g7ltt/USB-Soundcard-Interface-for-Digital-Modes/README.md

# USB Soundcard Interface for Digital Modes

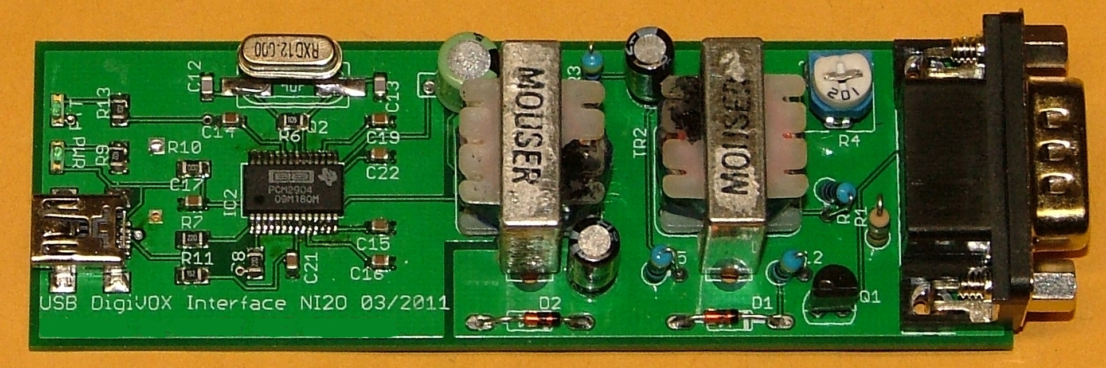
[picture p1: usb-radio-sound-card-interface-actual.jpg]
finished device


All-in-one interface for ham radio digital modes. Includes a USB sound card for simpler wiring. Uses VOX for PTT.
