g7ltt/USB-Soundcard-Interface-for-Digital-Modes/USB DigiVOX Interface V5.pdf

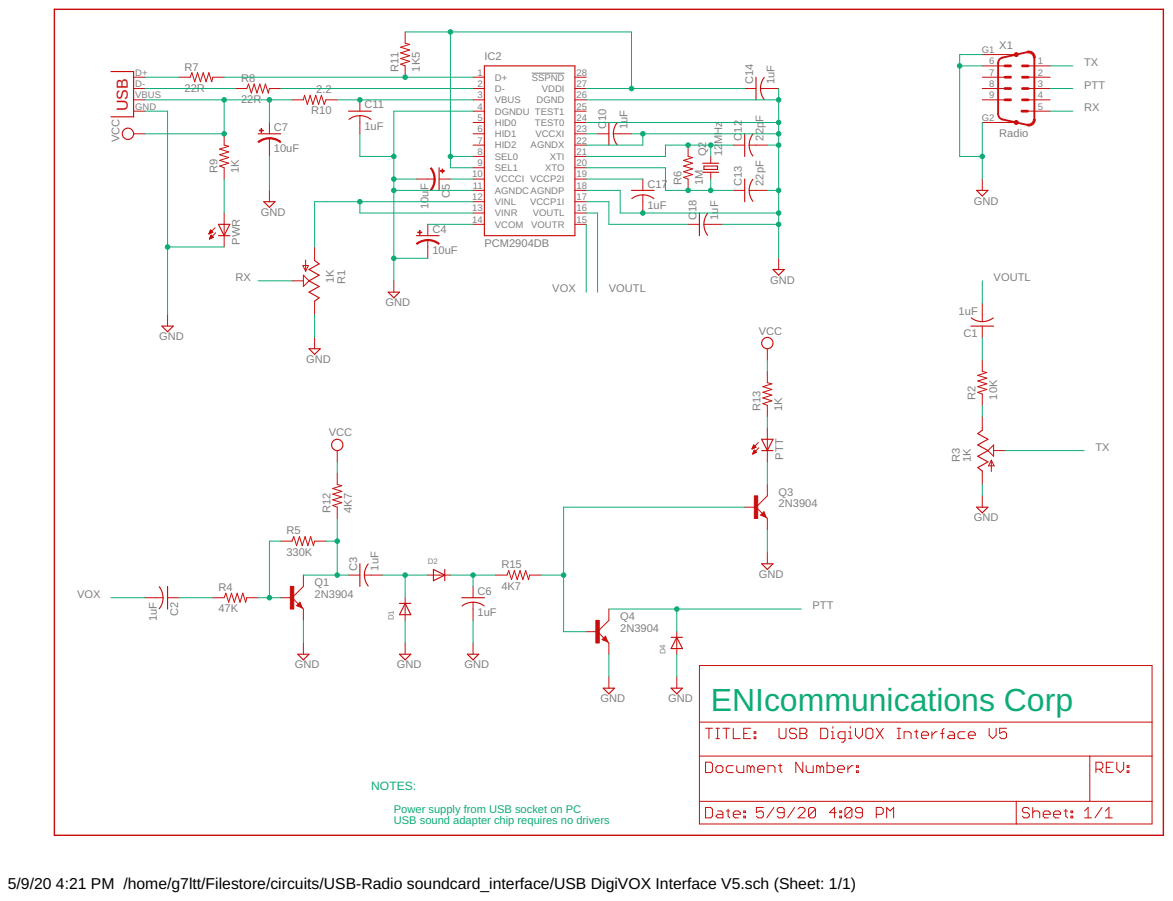
[picture p3: page 1]

NOTES: Power supply from USB socket on PC

5/9/20 4:21 PM /home/g7ltt/Filestore/circuits/USB-Radio soundcard_interface/USB DigiVOX Interface V5.sch (Sheet: 1/1)
