g7ltt/USB-Soundcard-Interface-for-Digital-Modes/USB DigiVOX Interface V5.brd

## EAGLE design USB DigiVOX Interface V5.brd (2021-11-11)

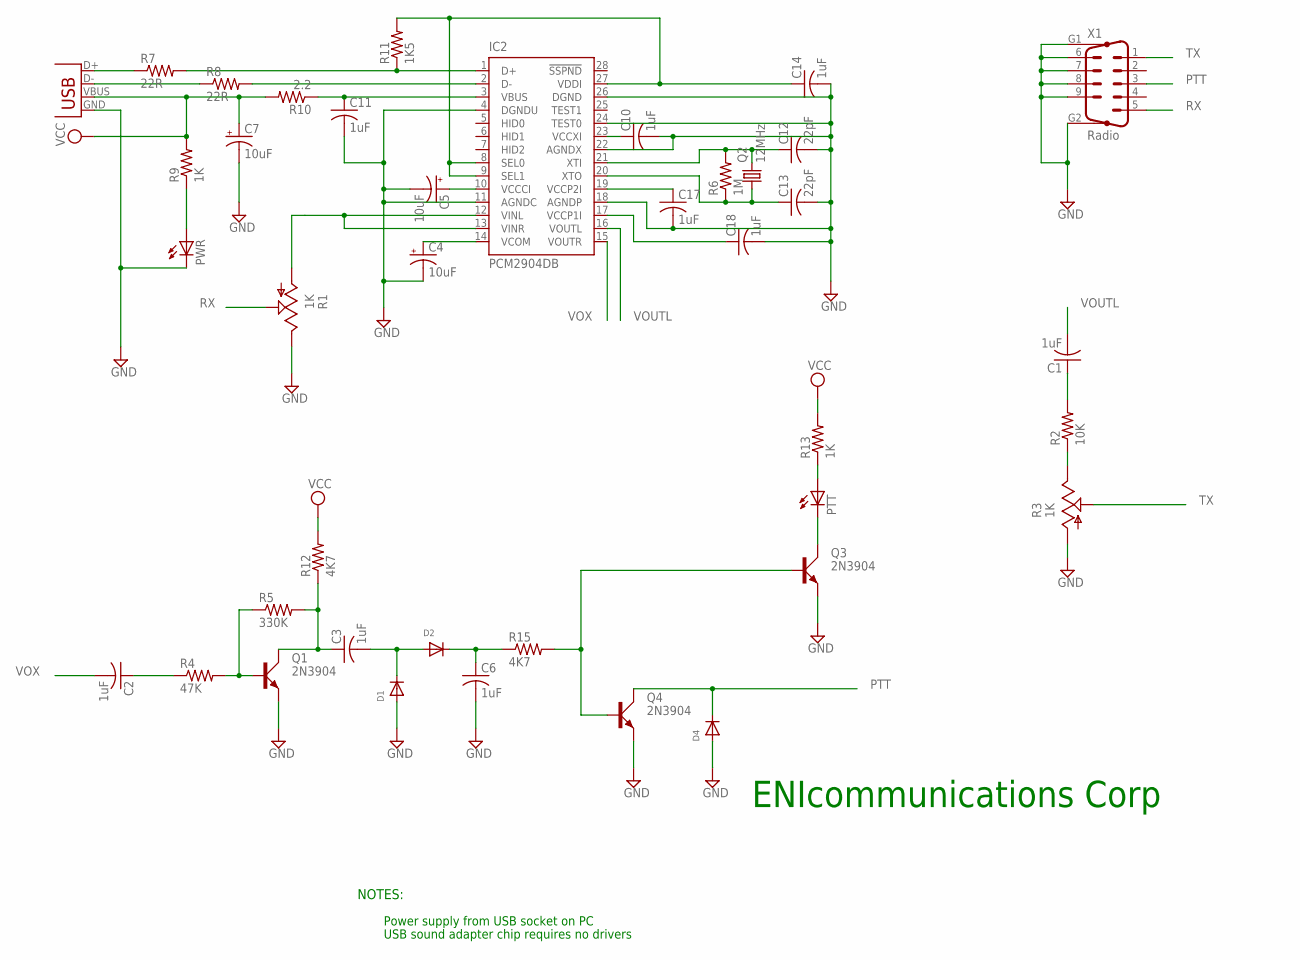
[picture p4: schematic USB DigiVOX Interface V5.sch]

Parts:
C1, C2, C3, C6, C10, C11, C14, C17, C18: 1uF; C025-025X050
C4, C5, C7: 10uF; CPOL-RADIAL-10UF-25V
C12, C13: 22pF; C025-025X050
D1, D2, D4: DIODEDO-1N4148; DO-1N4148
IC2: PCM2904DB; SSOP28DB
PTT: LED3MM
PWR: LED3MM
Q1, Q3, Q4: 2N3904; TO92D
Q2: 12MHz; HC49/S
R1, R3: 1K; CA6V
R2: 10K; 0204/7
R4: 47K; 0207/2V
R5: 330K; 0207/2V
R6: 1M; 0207/2V
R7, R8: 22R; 0207/2V
R9: 1K; 0207/2V
R10: 2.2; 0207/2V
R11: 1K5; 0207/2V
R12, R15: 4K7; 0207/2V
R13: 1K; 0204/7
X1: Radio; M09HP
X2: USBSMD; USB-MINIB

Connections:
GND: C4.2 (-), C5.2 (-), C6.2, C7.2 (-), C10.2, C11.2, C12.2, C13.2, C14.2, C17.2, C18.2, D1.A, D4.A, IC2.4 (DGNDU), IC2.11 (AGNDC), IC2.18 (AGNDP), IC2.22 (AGNDX), IC2.24 (TEST0), IC2.26 (DGND), PWR.K (C), Q1.E, Q3.E, Q4.E, R1.E, R3.A, X1.6, X1.7, X1.8, X1.9, X1.G1, X1.G2, X2.GND
unnamed: C1.1, R2.2
unnamed: R2.1, R3.E
unnamed: C5.1 (+), IC2.10 (VCCCI)
unnamed: C12.1, IC2.21 (XTI), Q2.2, R6.2
unnamed: PWR.A, R9.1
unnamed: C13.1, IC2.20 (XTO), Q2.1, R6.1
unnamed: C10.1, IC2.23 (VCCXI)
unnamed: C2.1, R4.1
unnamed: C4.1 (+), IC2.14 (VCOM)
unnamed: Q1.B, R4.2, R5.1
unnamed: C3.1, Q1.C, R5.2, R12.1
unnamed: C3.2, D1.C, D2.A
unnamed: C14.1, IC2.8 (SEL0), IC2.9 (SEL1), IC2.27 (VDDI), R11.2
unnamed: C6.1, D2.C, R15.1
unnamed: C11.1, IC2.3 (VBUS), R10.1
unnamed: Q3.B, Q4.B, R15.2
unnamed: R7.1, X2.D+
unnamed: C17.1, IC2.19 (VCCP2I)
unnamed: IC2.1 (D+), R7.2, R11.1
unnamed: IC2.2 (D-), R8.2
unnamed: PTT.K (C), Q3.C
unnamed: R8.1, X2.D-
unnamed: PTT.A, R13.1
unnamed: C18.1, IC2.17 (VCCP1I)
PTT: D4.C, Q4.C, X1.3
RX: R1.S, X1.5
TX: R3.S, X1.1
VCC: C7.1 (+), R9.2, R10.2, R12.2, R13.2, X2.VBUS
VINL: IC2.12 (VINL), IC2.13 (VINR), R1.A
VOUTL: C1.2, IC2.16 (VOUTL)
VOX: C2.2, IC2.15 (VOUTR)

Notes on the sheet:
NOTES:
Power supply from USB socket on PC
USB sound adapter chip requires no drivers
ENIcommunications Corp

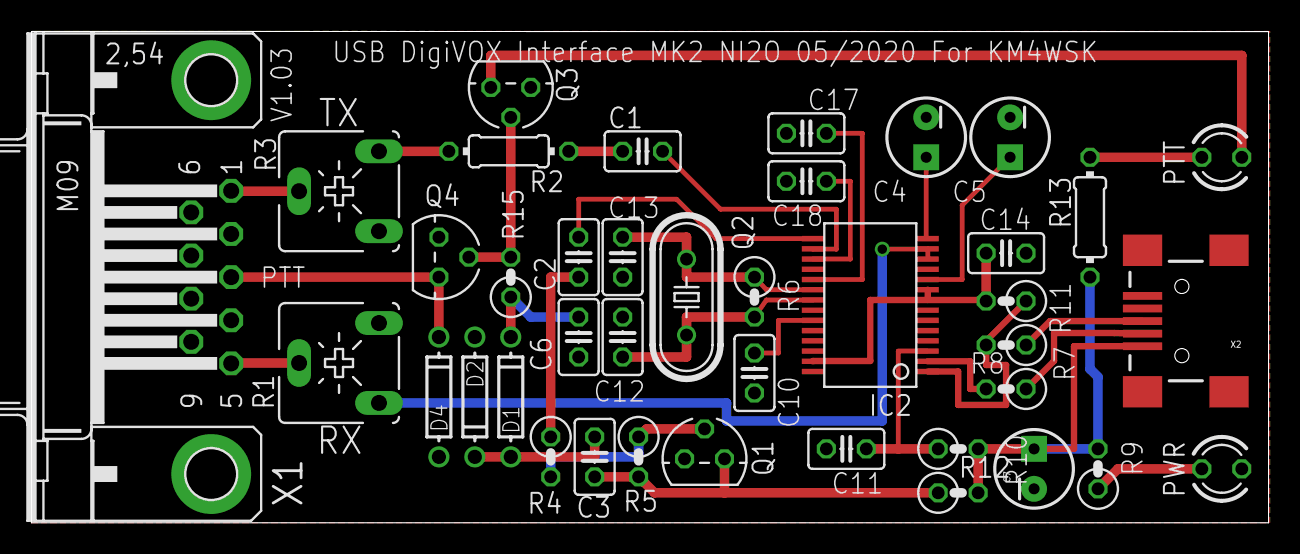
[picture p5: board USB DigiVOX Interface V5.brd from above]

Board: 2 copper layers, 78.7 x 31.2 mm, 40 parts (0 on the bottom side), 32 nets.
