g7ltt/USB-Soundcard-Interface-for-Digital-Modes/USB DigiVOX Interface.brd

## EAGLE design USB DigiVOX Interface.brd (2021-09-01, an earlier design)

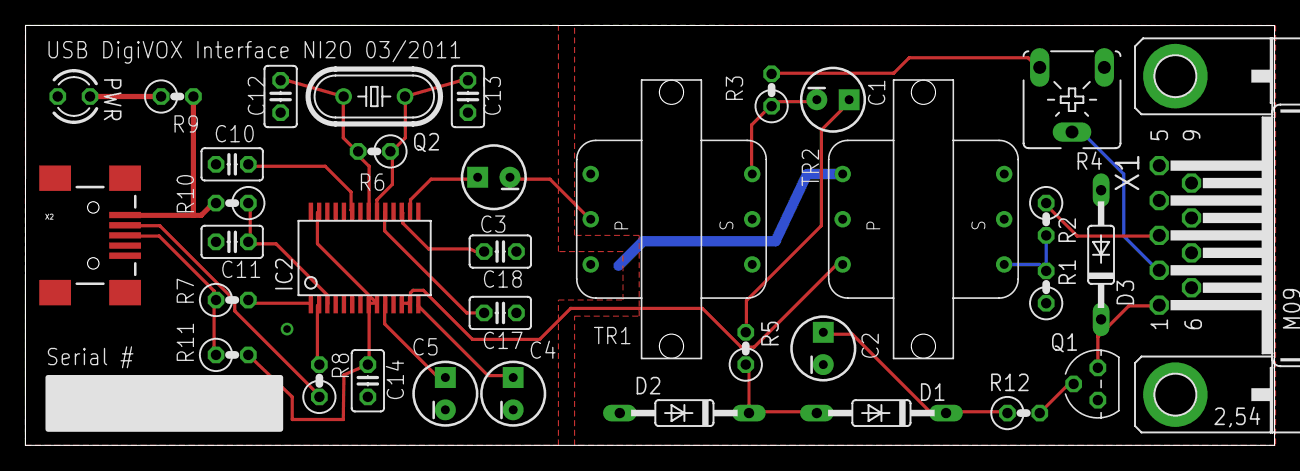
[picture p6: board USB DigiVOX Interface.brd from above]

Board: 2 copper layers, 98.2 x 33.0 mm, 35 parts (0 on the bottom side), 30 nets.

Parts:
C1, C2, C4, C5: 10uF; CPOL-RADIAL-10UF-25V
C3: 4.7uF; CPOL-RADIAL-10UF-25V
C10, C11, C14, C17, C18: 1uF; C025-025X050
C12, C13: 22pF; C025-025X050
D1, D2, D3: 1N4148; DO35-10
IC2: PCM2904DB; SSOP28DB
PWR: LED3MM
Q1: 2N3904; TO92
Q2: 12MHz; HC49/S
R1: 680R; 0207/2V
R2: 10K; 0207/2V
R3, R5: 4k7; 0207/2V
R4: 1K; CA6V
R6: 1M; 0207/2V
R7, R8: 22R; 0207/2V
R9: 1K; 0207/2V
R10: 2.2; 0207/2V
R11: 1K5; 0207/2V
R12: 2k2; 0207/2V
TR1, TR2: 42TM016; 42TM
X1: M09HP
X2: USBSMD; USB-MINIB

Connections:
GND: C4.2, C5.2, C10.2, C11.2, C12.2, C13.2, C14.2, C17.2, C18.2, IC2.4, IC2.11, IC2.18, IC2.22, IC2.24, IC2.26, PWR.K, TR1.3, TR2.1, X2.GND
GNDA: C2.2, D2.A, D3.A, Q1.3, R1.1, R4.A, TR1.4, TR2.6, X1.5, X1.G1, X1.G2
INPUT: IC2.12, IC2.13, TR2.3
unnamed: C3.1, IC2.16
unnamed: C1.2, R3.1, TR1.6
unnamed: C5.1, IC2.10
unnamed: C12.1, IC2.21, Q2.2, R6.2
unnamed: PWR.A, R9.1
unnamed: C13.1, IC2.20, Q2.1, R6.1
unnamed: C10.1, IC2.23
unnamed: R1.2, R2.2, TR2.4
unnamed: C4.1, IC2.14
unnamed: C1.1, R5.2
unnamed: D1.A, D2.C, R5.1
unnamed: C14.1, IC2.8, IC2.9, IC2.27, R11.2
unnamed: C3.2, TR1.2
unnamed: C11.1, IC2.3, R10.1
unnamed: Q1.2, R12.2
unnamed: R3.2, R4.E
unnamed: C17.1, IC2.19
unnamed: R7.1, R11.1, X2.D+
unnamed: IC2.2, R8.2
unnamed: IC2.1, R7.2
unnamed: R8.1, X2.D-
unnamed: C2.1, D1.C, R12.1
unnamed: C18.1, IC2.17
PTT: D3.C, Q1.1, X1.1
RX: R2.1, X1.3
TX: R4.S, X1.2
VCC: R9.2, R10.2, X2.VBUS
