g7ltt/USB-Soundcard-Interface-for-Digital-Modes/Simple USB SC Interface.brd

## EAGLE design Simple USB SC Interface.brd (2021-09-01)

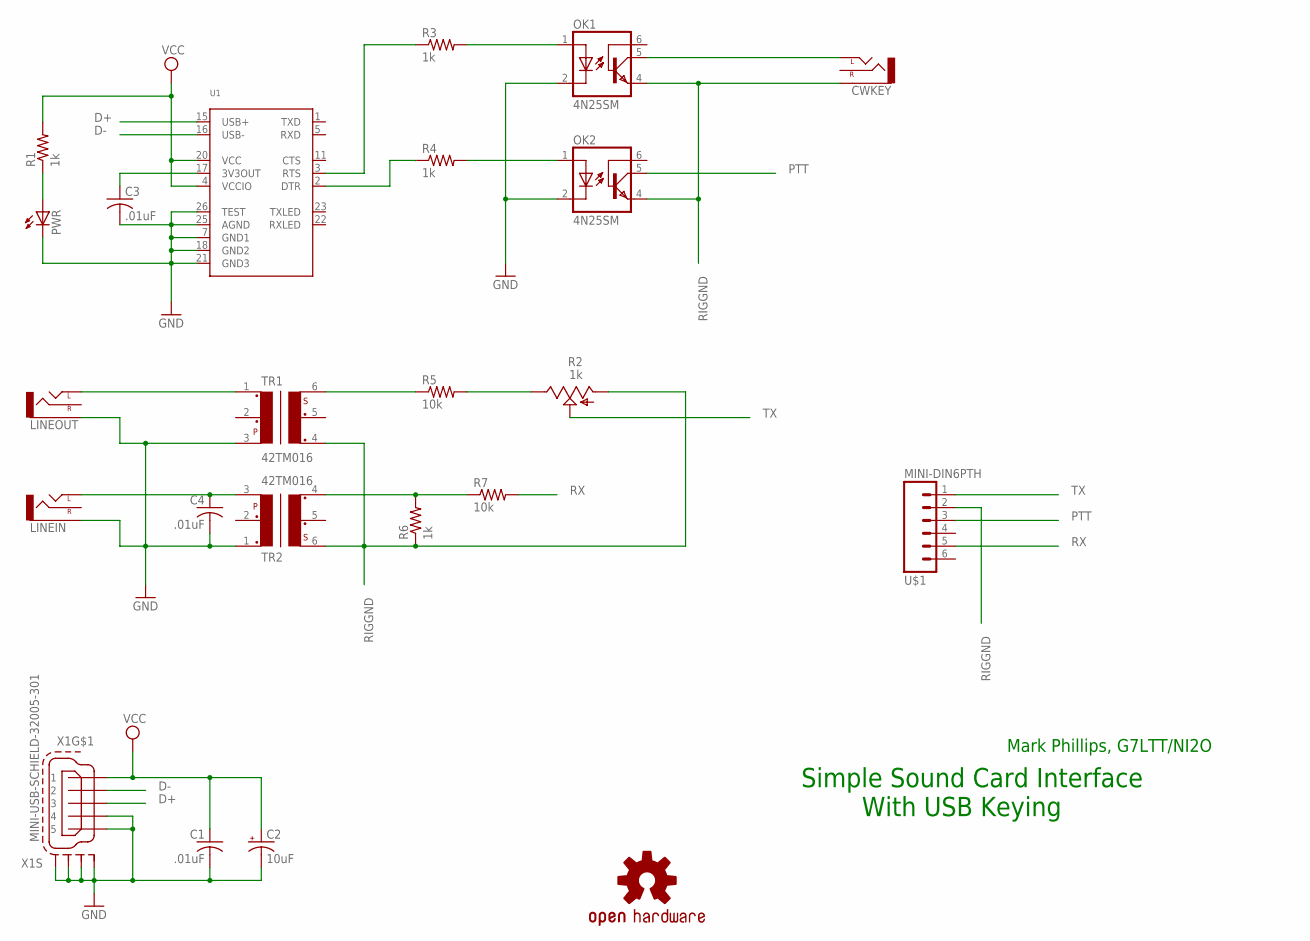
[picture p7: schematic Simple USB SC Interface.sch]

Parts:
C1, C3, C4: .01uF; C0805
C2: 10uF; E2,5-5
CWKEY: AUDIO-JACKSMD2; AUDIO-JACK-3.5MM-SMD
LINEIN: AUDIO-JACKSMD2; AUDIO-JACK-3.5MM-SMD
LINEOUT: AUDIO-JACKSMD2; AUDIO-JACK-3.5MM-SMD
LOGO1: OSHW-LOGOM; OSHW-LOGO-M
OK1, OK2: 4N25SM; DIL6-SMD
PWR: LEDCHIP-LED0805; CHIP-LED0805
R1, R3, R4, R6: 1k; M0805
R2: 1k; CA6V
R5, R7: 10k; M0805
TR1, TR2: 42TM016; 42TM
U1: FT232RLSSOP28; SSOP28DB
U$1: MINI-DIN6PTH; MINI-DIN6
X1: MINI-USB-SCHIELD-32005-301; 32005-301

Connections:
CWKEY: CWKEY.TIP (LEFT), OK1.5 (COL)
D+: U1.15 (USB+), X1.3
D-: U1.16 (USB-), X1.2
GND: C1.2, C2.-, C3.2, C4.2, LINEIN.SLEEVE, LINEOUT.SLEEVE, OK1.2 (C), OK2.2 (C), PWR.C, TR1.3, TR2.1, U1.7 (GND1), U1.18 (GND2), U1.21 (GND3), U1.25 (AGND), U1.26 (TEST), X1.4, X1.5, X1.M1 (S1), X1.M2 (S2), X1.M3 (S3), X1.M4 (S4)
unnamed: PWR.A, R1.1
unnamed: OK1.1 (A), R3.2
unnamed: C3.1, U1.17 (3V3OUT)
unnamed: OK2.1 (A), R4.2
unnamed: R3.1, U1.3 (RTS)
unnamed: R4.1, U1.2 (DTR)
unnamed: C4.1, LINEIN.TIP (LEFT), TR2.3
unnamed: LINEOUT.TIP (LEFT), TR1.1
unnamed: R5.1, TR1.6
unnamed: R2.E, R5.2
unnamed: R6.2, R7.1, TR2.4
PTT: OK2.5 (COL), U$1.3
RIGGND: CWKEY.SLEEVE, OK1.4 (EMI), OK2.4 (EMI), R2.A, R6.1, TR1.4, TR2.6, U$1.2
RX: R7.2, U$1.5
TX: R2.S, U$1.1
VCC: C1.1, C2.+, R1.2, U1.4 (VCCIO), U1.20 (VCC), X1.1

Notes on the sheet:
Simple Sound Card Interface With USB Keying
Mark Phillips, G7LTT/NI2O

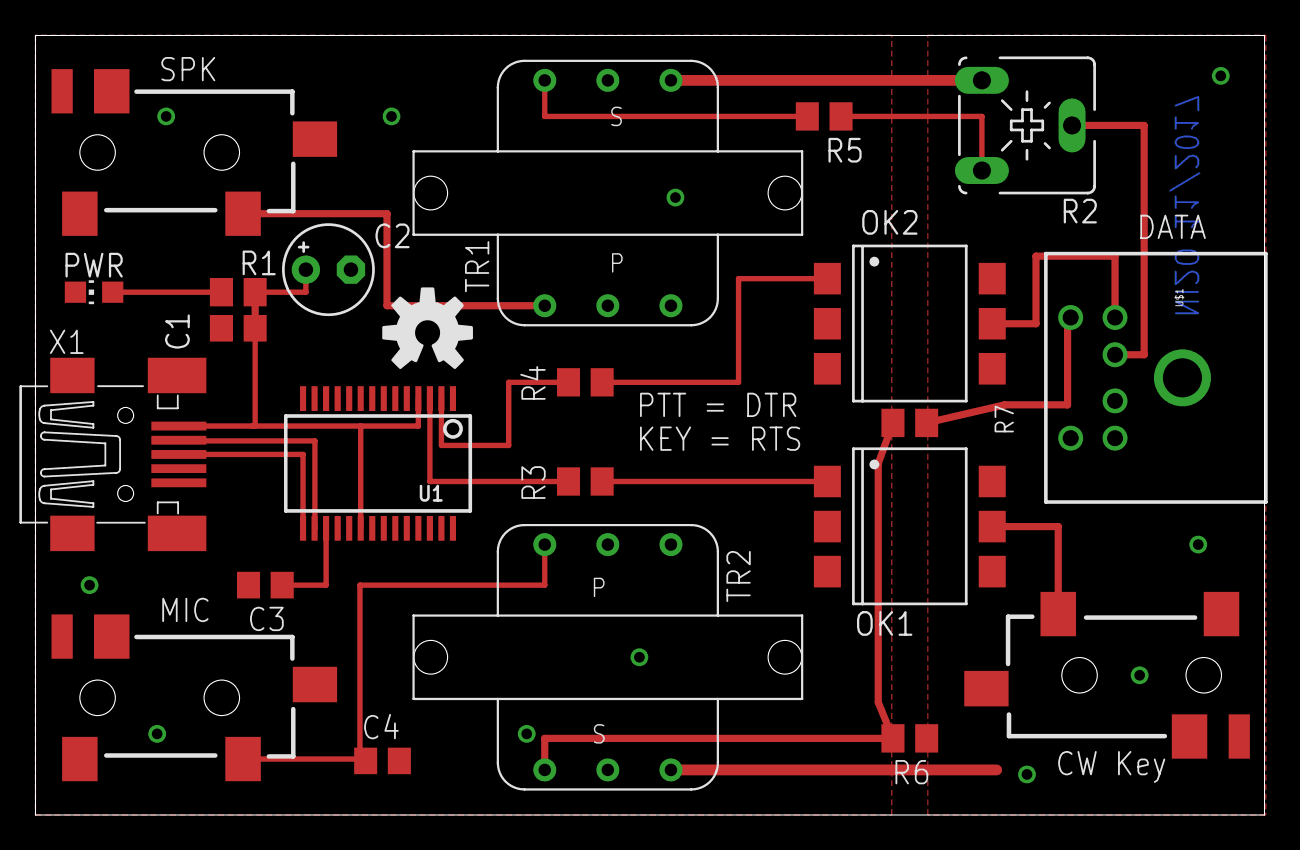
[picture p8: board Simple USB SC Interface.brd from above]

Board: 2 copper layers, 69.3 x 43.9 mm, 23 parts (0 on the bottom side), 20 nets.
